85NTK/Blood-pressure/(list of files, drawings)

Other design files:
Simulation/DO-HUYET-AP-NANO-2.pdsprj
